SIGMusic/Grand-Piano/cad/mechanical/README.md

# Mechanical design

## Schematic

See piano.pdf for a rough schematic. piano.xcf is the GIMP source file.

**Notes**
* White keys: 11.75" x 36"
* Black keys: 6.75" x 18"
* Foam border: 2" wide
* Plywood fulcrums: 11.75" x 4" for white keys, 6.75" x 2" for black keys
    - Cut from the plywood sheet scrap
* Can we cut all these with a table saw? If not, a bandsaw/scroll saw could work.

## Bill Of Materials

* (1) [4’ x 8’ x 0.25” plywood sheet](http://www.homedepot.com/p/1-4-in-x-4-ft-x-8-ft-BC-Sanded-Pine-Plywood-166014/100063669), cut to 3.5' wide - keep the 0.5' scrap!
* (4) [24” x 36” natural corrugated plastic sheets](http://www.homedepot.com/p/24-in-x-36-in-x-0-157-in-Natural-Twin-Wall-Plastic-Sheet-1TW3624C/205828979)
* (1) [24” x 36” black corrugated plastic sheets](http://www.homedepot.com/p/24-in-x-36-in-x-0-157-in-Black-Twin-Wall-Plastic-Sheet-COR3624BK/205437929)
* (2) [24" x 54" x 0.25” high-density polyethylene foam](https://www.grainger.com/product/GRAINGER-APPROVED-Foam-Sheet-5GDK0)
* (51) [#6 x 3/4" wood screws](http://www.homedepot.com/p/Everbilt-6-x-3-4-in-Stainless-Steel-Phillips-Flat-Head-Wood-Screw-3-per-Pack-800768/204275519)
* (51) [3/16" washers](http://www.homedepot.com/p/Everbilt-3-16-in-x-1-1-4-in-Zinc-Plated-Fender-Washer-100-Piece-per-Box-804780/204276326)
