SIGMusic/Grand-Piano/cad/mechanical/piano.pdf

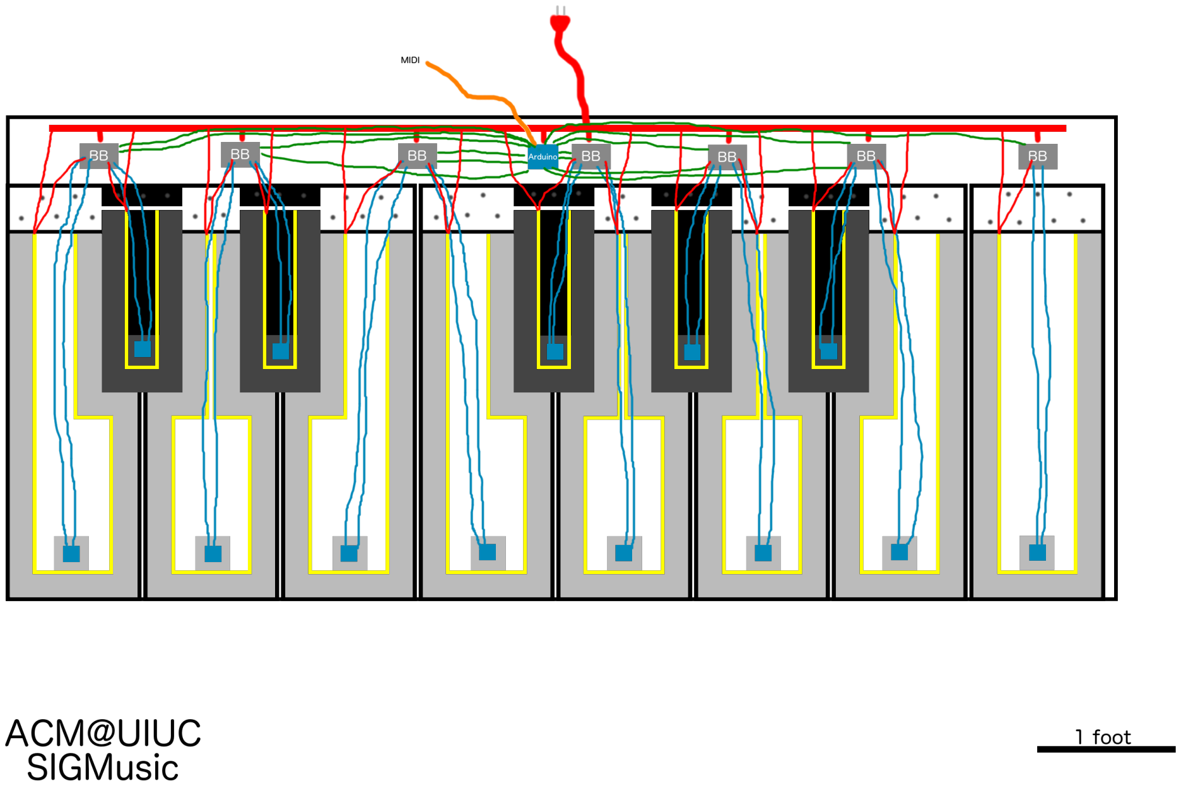
[picture p1: page 1]
