SIGMusic/Grand-Piano/cad/electrical/controller.pdf

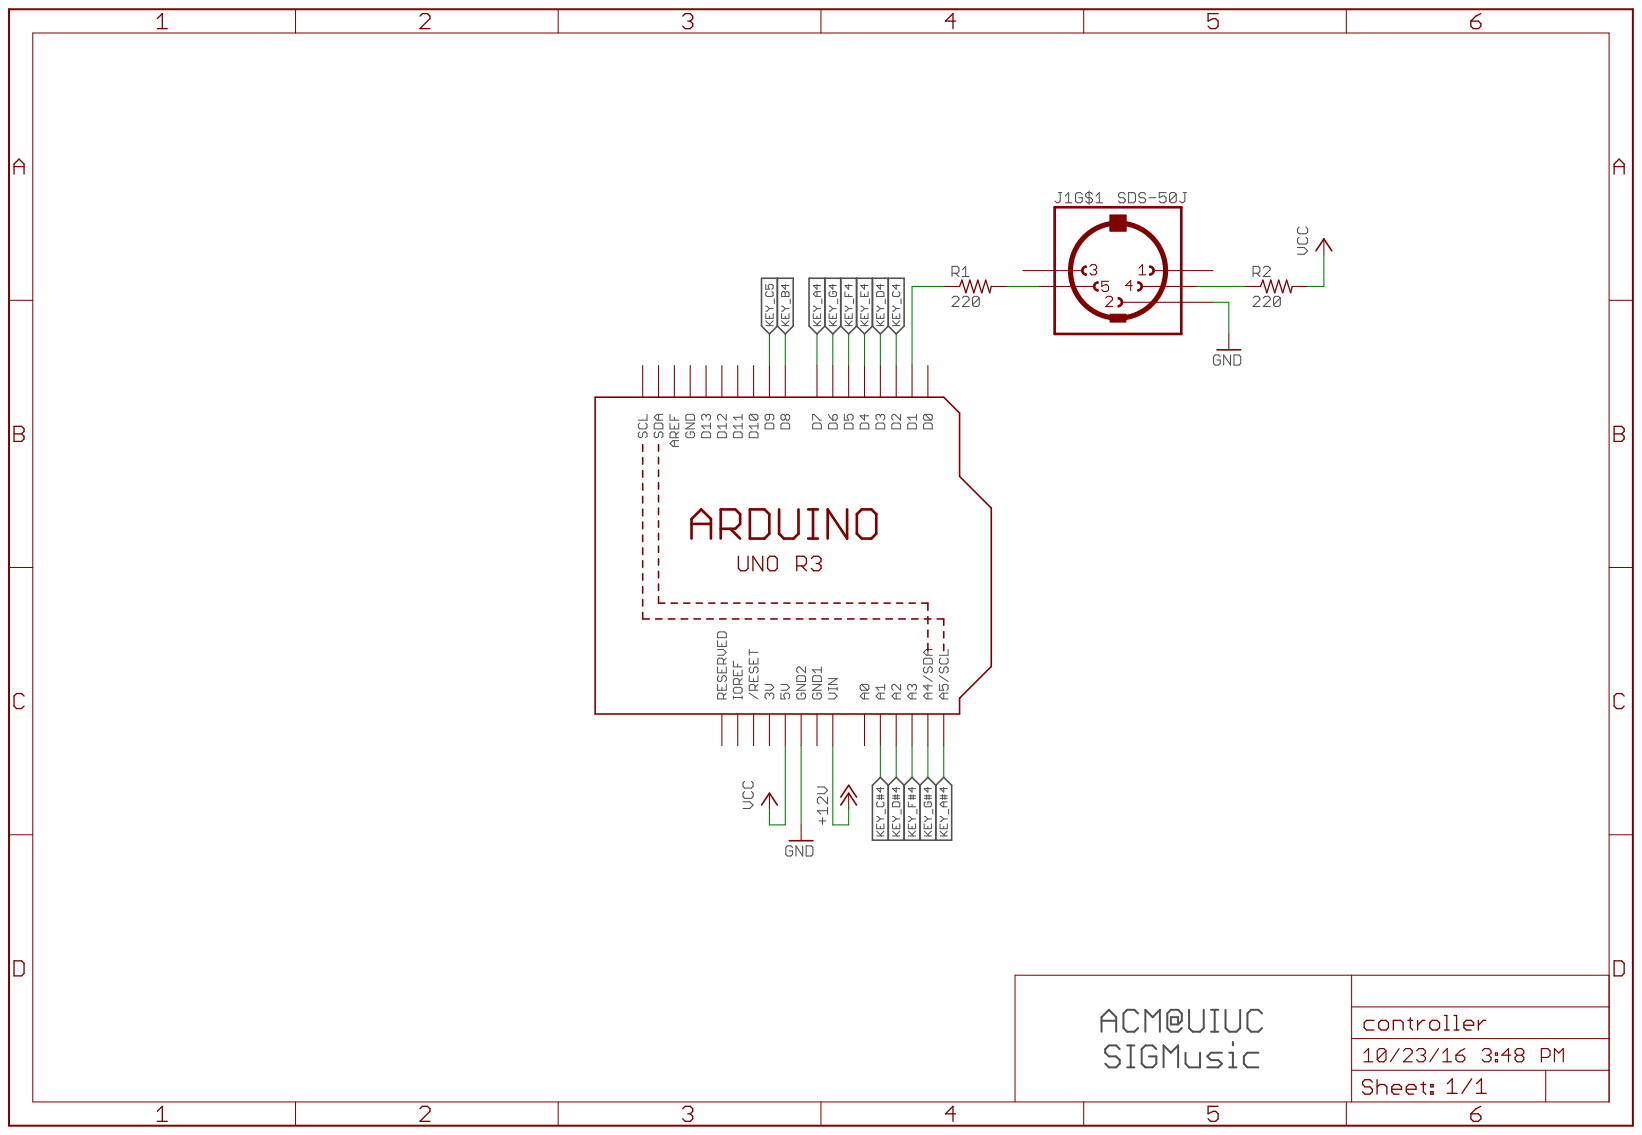
[picture p2: page 1]
