SIGMusic/Grand-Piano/cad/electrical/key.pdf

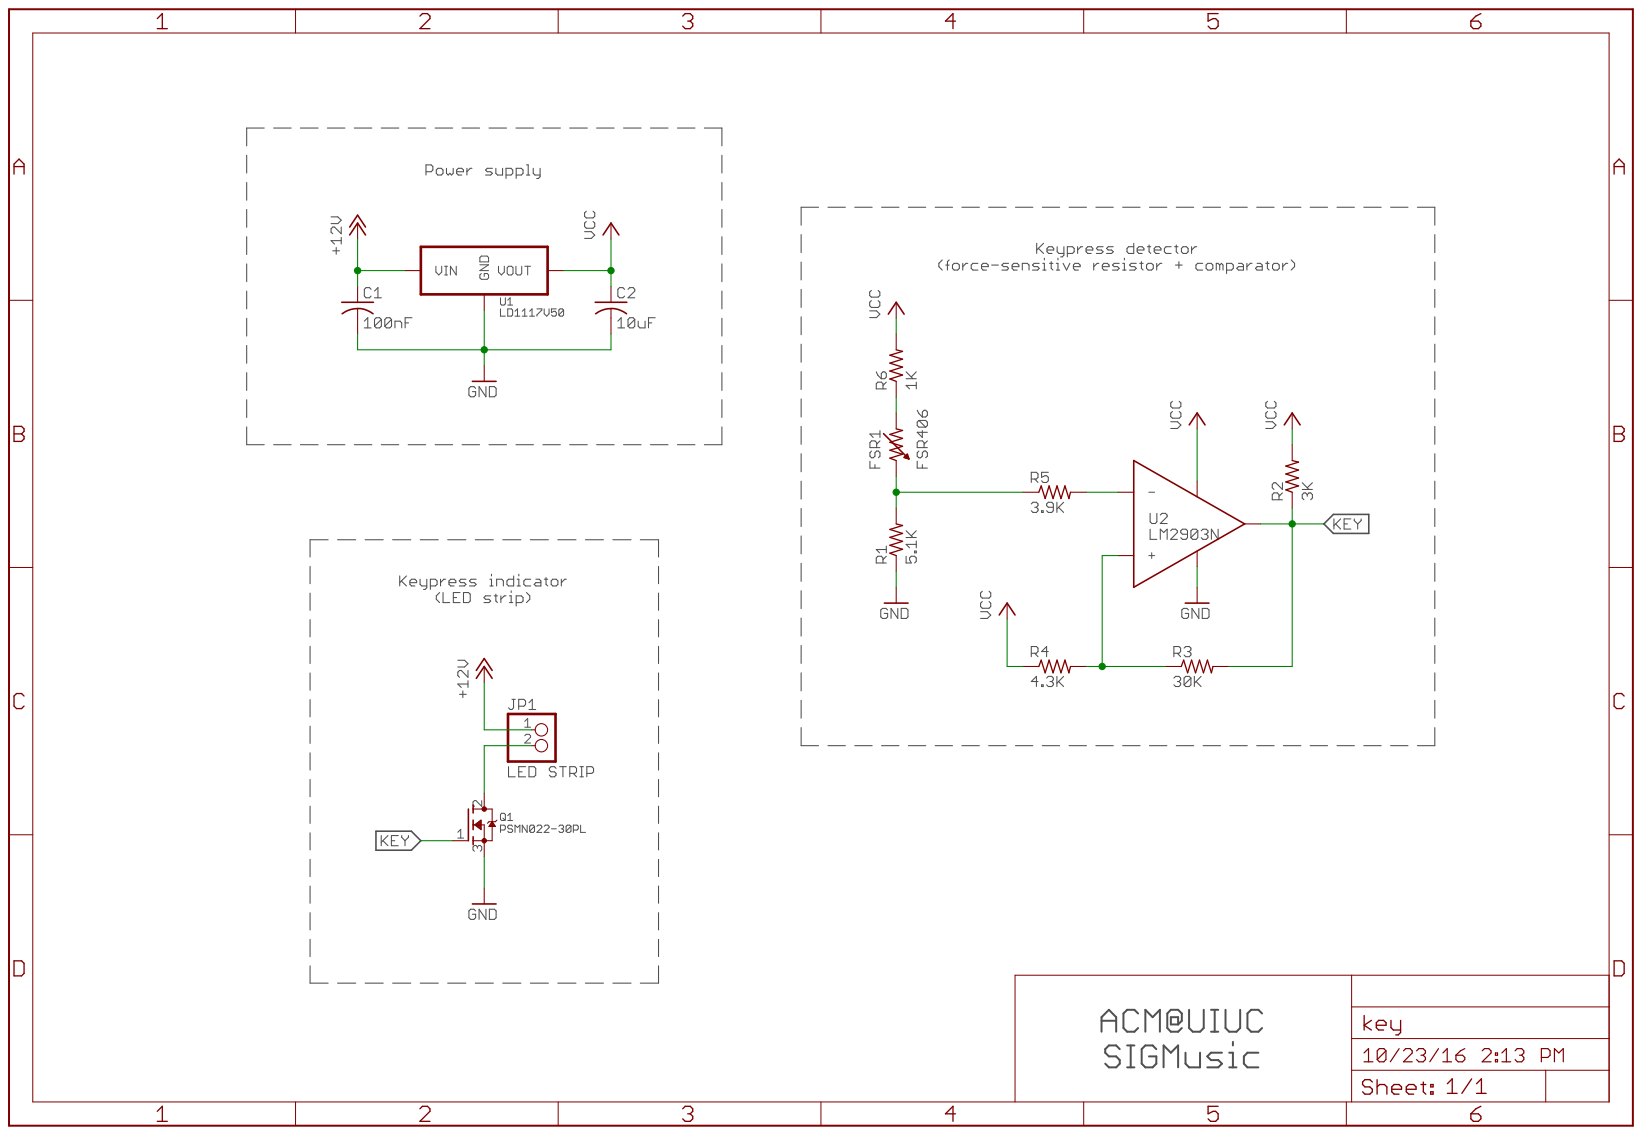
[picture p3: page 1]
