SIGMusic/Grand-Piano/cad/electrical/controller.sch

## EAGLE design cad/electrical/controller.sch (2016-10-25)

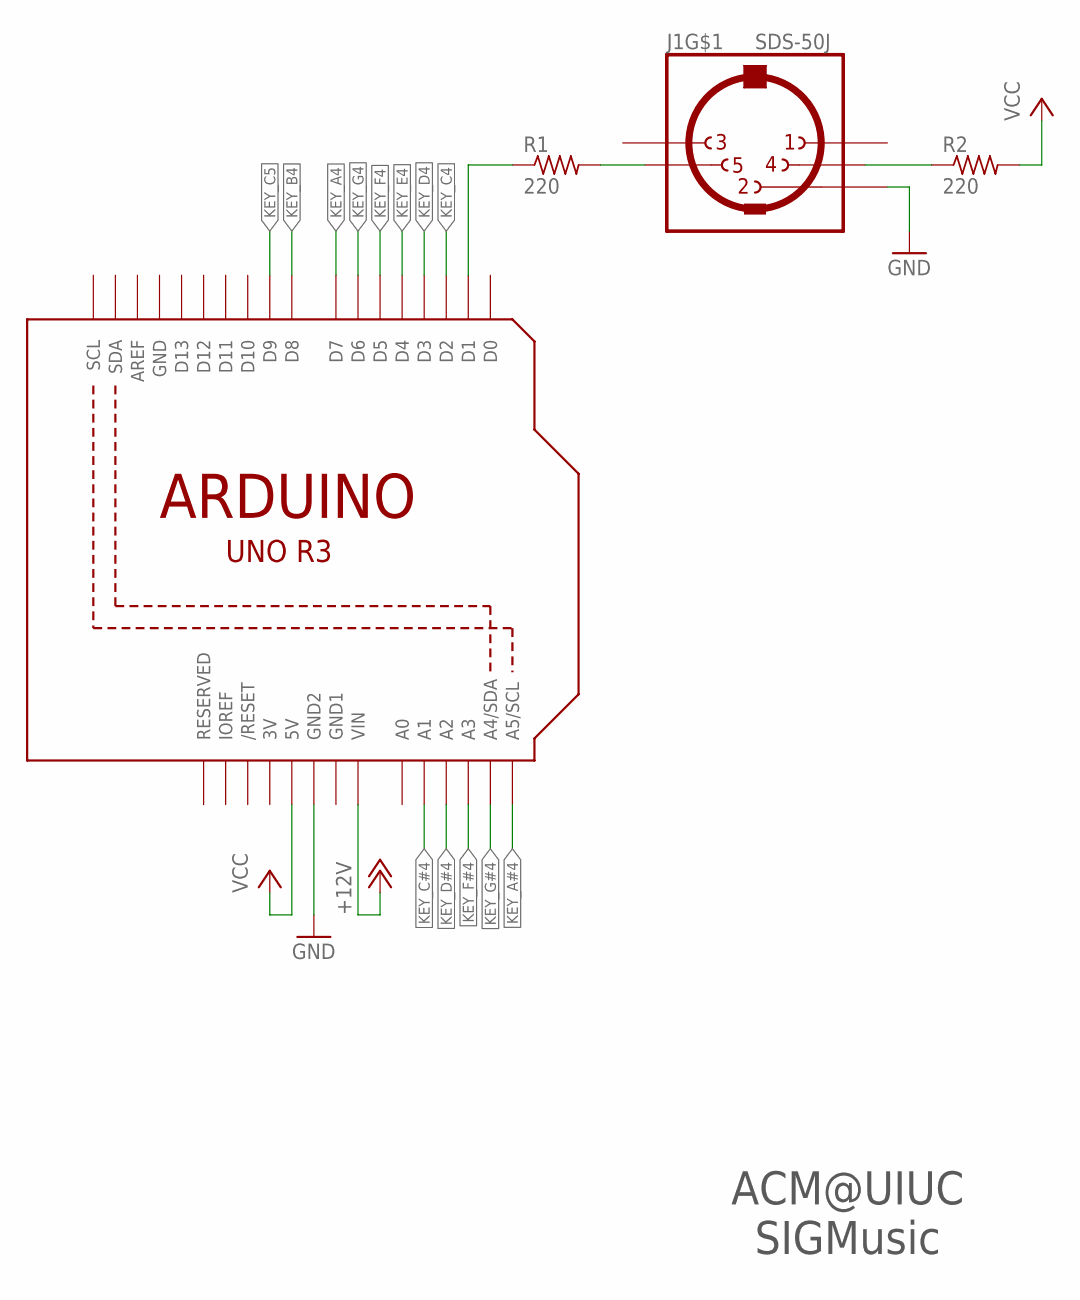
[picture p4: schematic controller.sch]

Parts:
J1: SDS-50J; CP-2350
R1, R2: 220; 0207/10
U1: ARDUINOR3-BPLACE

Connections:
+12V: U1.VIN
GND: J1.2, U1.GND2
KEY_A4: U1.D7
KEY_A#4: U1.A5 (A5/SCL)
KEY_B4: U1.D8
KEY_C4: U1.D2
KEY_C5: U1.D9
KEY_D4: U1.D3
KEY_D#4: U1.A2
KEY_E4: U1.D4
KEY_F4: U1.D5
KEY_F#4: U1.A3
KEY_G4: U1.D6
KEY_G#4: U1.A4 (A4/SDA)
unnamed: R1.1, U1.D1
unnamed: J1.5, R1.2
unnamed: J1.4, R2.1
VCC: R2.2, U1.5V

Notes on the sheet:
ACM@UIUC SIGMusic
