SIGMusic/Grand-Piano/cad/electrical/key.sch

## EAGLE design cad/electrical/key.sch (2016-10-25)

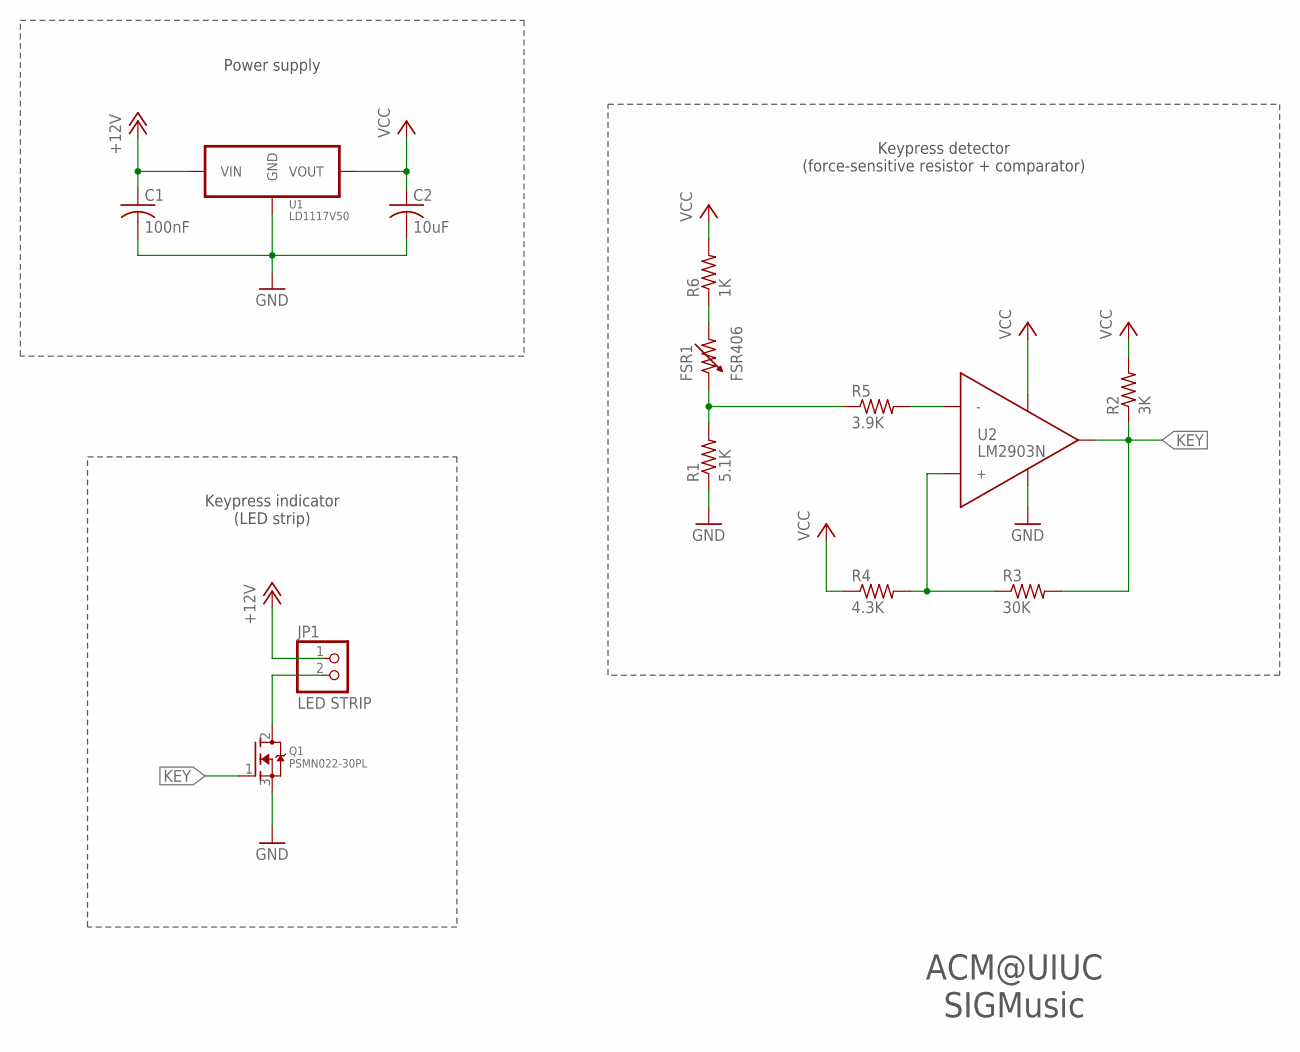
[picture p5: schematic key.sch]

Parts:
C1: 100nF; C025-025X050
C2: 10uF; C025-025X050
FSR1: FSR406; FSR-SQUARE
JP1: LED STRIP; 1X02/90
Q1: PSMN022-30PL; TO220V
R1: 5.1K; 0207/10
R2: 3K; 0207/10
R3: 30K; 0207/10
R4: 4.3K; 0207/10
R5: 3.9K; 0207/10
R6: 1K; 0207/10
U1: LD1117V50; TO-220
U2: LM2903N; DIL08

Connections:
+12V: C1.1, JP1.1, U1.P$3 (VIN)
FORCE: FSR1.P$1 (1), R1.2, R5.1
GND: C1.2, C2.2, Q1.3 (S), R1.1, U1.P$1 (GND), U2.4 (GND)
KEY: Q1.1 (G), R2.1, R3.2, U2.1
unnamed: FSR1.P$2 (2), R6.1
unnamed: JP1.2, Q1.2 (D)
unnamed: R3.1, R4.2, U2.3 (+)
unnamed: R5.2, U2.2 (-)
VCC: C2.1, R2.2, R4.1, R6.2, U1.P$2 (VOUT), U2.8 (VCC)

Notes on the sheet:
ACM@UIUC SIGMusic
Power supply
Keypress detector (force-sensitive resistor + comparator)
Keypress indicator (LED strip)
