SIGMusic/Grand-Piano/viz/pianoVizTest/piano.png

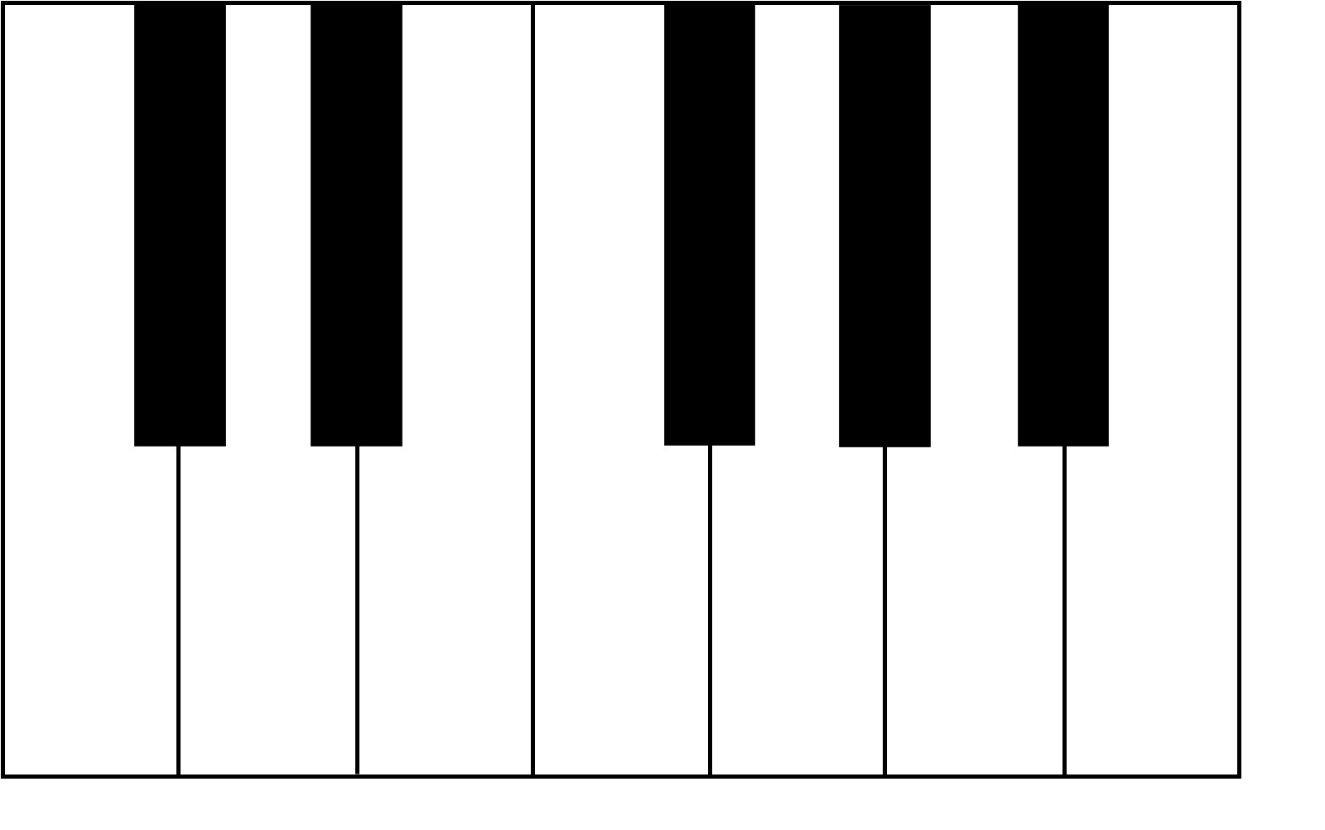
viz/pianoVizTest/piano.png
