SIGMusic/Grand-Piano/(commit log)

2016-10-16 Forgot to stop the note when the key was no longer being pressed!
    [midi_controller.ino]
2016-10-17 Initial key sensor schematic
    [key.sch]
2016-10-21 Updated schematic and BOMs
    [key.sch]
2016-10-21 Fixed incorrect text on schematic
    [key.sch]
2016-10-22 add sample app.js
2016-10-23 Fixed comparator part
    [key.sch]
2016-10-23 Clarified FSR value
    [key.sch]
2016-10-23 Adjusted voltage divider to limit current through FSR to 1mA
    [key.sch]
2016-10-23 Added MIDI jack and Arduino connections
    [controller.sch]
2016-10-23 Switched to 0.25" plywood instead of 0.5"
2016-10-23 Switched to actual 1/4" plywood, not 7/32"
2016-10-23 Need to share power supplies if sharing comparators
2016-10-25 Added rough schematic
2016-10-25 Finalized BOM
2016-10-27 Added pianoVizTest folder
    This has all the files needed for the piano, including the background image, and also the wav sample files
2016-10-31 Keyboard firmware has been written! (#10)
    * Add design overview
    * Design overview: Added C5 to natural notes list and reassigned black keys to pins A1 - A5
    * Fixed port numbers
    * Moved MIDI library up one directory
    * Defined MIDI note IDs and created Note struct
    * Created Key class
    * MIDI notes should now transmit when a key is pressed! (untested)
    * Renamed 'm_midiID' to 'm_id'
    * Removed ability to send MIDI command from within class
    All MIDI operations are now handled by the main loop; added setPressed() function to record whether a key is being pressed; added getNote() function to retrieve the note that corresponds to the key
    * Main loop now sends MIDI command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
    [Key.cpp, Key.hpp, MIDI_Basic_IO.ino, MIDI_Bench.ino, MIDI_Callbacks.ino]
